harbaum/I2C-Tiny-USB/images/n800.jpg

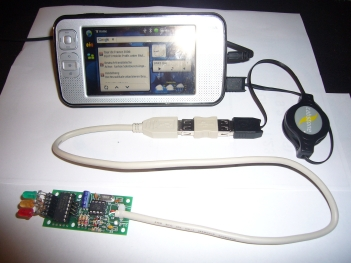
images/n800.jpg
