harbaum/I2C-Tiny-USB/images/screenshot_small.gif

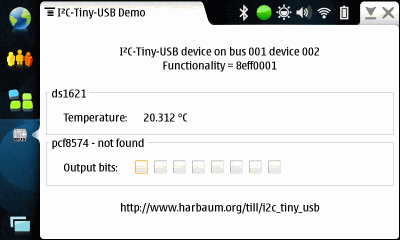
images/screenshot_small.gif
