harbaum/I2C-Tiny-USB/pcb/i2c-tiny-usb/images/i2c-tiny-usb-3d-render.png

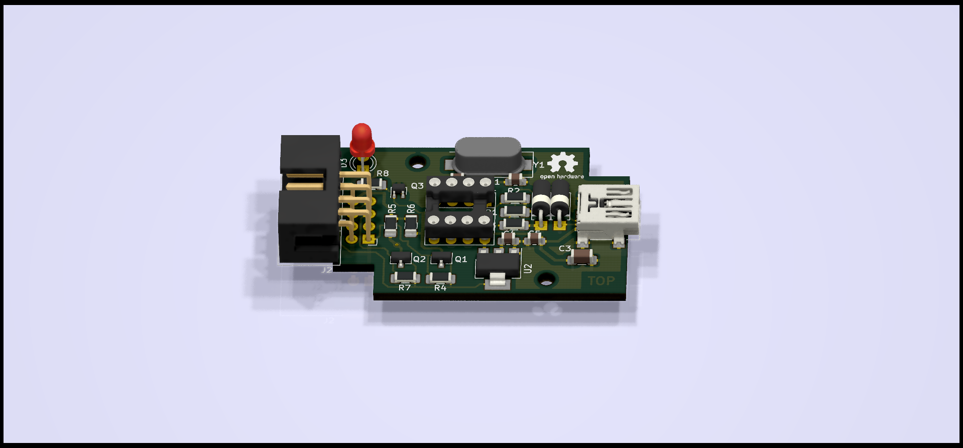
pcb/i2c-tiny-usb/images/i2c-tiny-usb-3d-render.png
