harbaum/I2C-Tiny-USB/pcb/i2c-tiny-usb/images/i2c_tiny_usb_protos.png

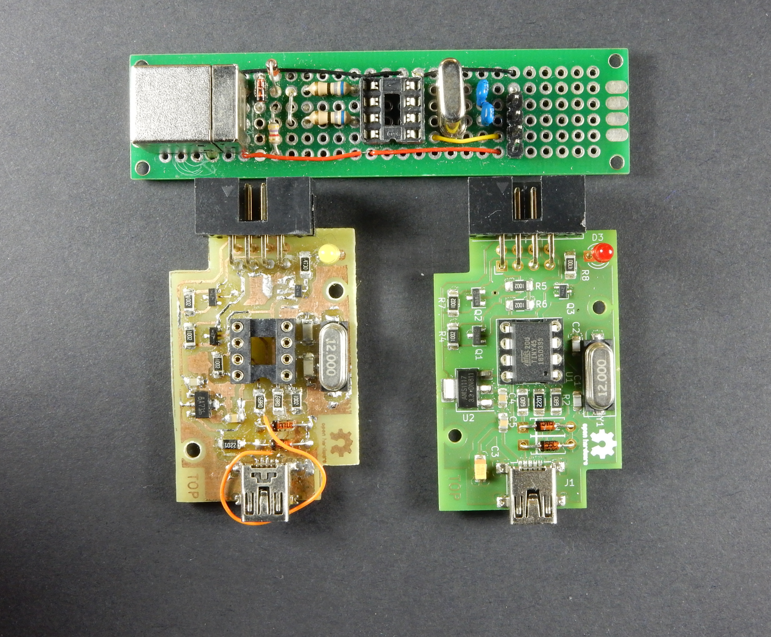
pcb/i2c-tiny-usb/images/i2c_tiny_usb_protos.png
