harbaum/I2C-Tiny-USB/pcb/i2c-tiny-usb/enclosure/i2c-tiny-usb.stl

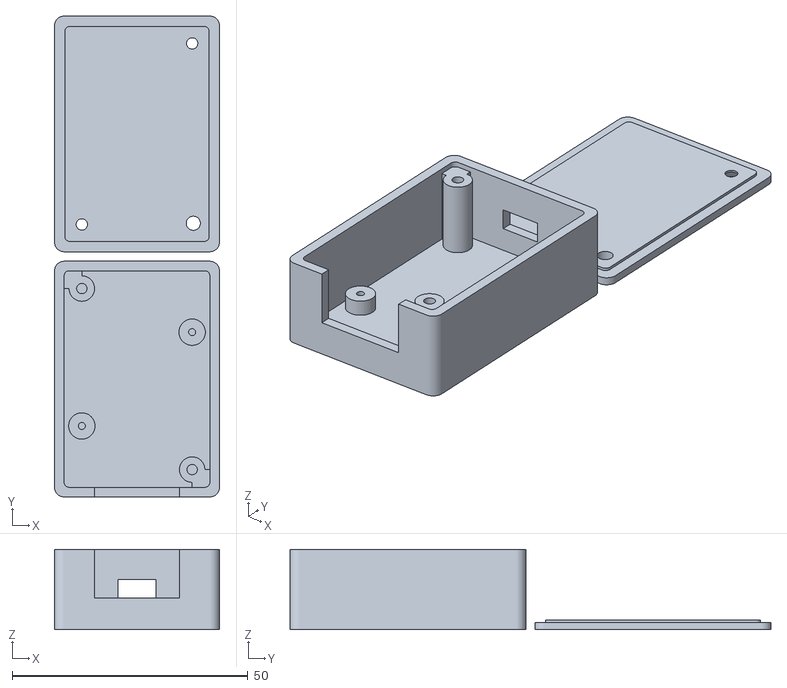
[picture p15: CAD file, 2020-04-05]
pcb/i2c-tiny-usb/enclosure/i2c-tiny-usb.stl
35.0 x 102.0 x 17.0
