harbaum/I2C-Tiny-USB/(threads)

Thread 1 (2017-10-29):

README.md / Henning Pauls i2c-tiny-usb

drawkula, 2017-10-29:
The "Henning Pauls i2c-tiny-usb"  link in "README.md" now points into digital nirwana.

[...but archive.org still has that page.](https://web.archive.org/web/20161015190723/http://home.arcor.de/henning.paul/gallery/avr/)

harbaum, 2017-10-29:
Fixed, thanks.

Closed 2017-10-29.

Thread 4 (2017-11-21):

USB_CFG_LONG_TRANSFERS?

mzwtjp, 2017-11-21:
Hello.
I am trtying i2c-tiny-usb + digispark for my project.
This is a linux host.

I am now trying CFG_USB_LONG_TRANSFERS in usbconfig.h with 1 since I am seeing my I2C read() fails with 205 bytes or larger data.

Though I have not succeeded yet with the larger data transfers, at least I think following changes are needed in order to build this configuration properly.
(At least, passing compilation.)

I wonder if anyone already tried CFG_USB_LONG_TRANSFER configuration.
Or possible clue to solve my issue of not able to read() 205 bytes or more?

====
diff --git a/digispark/main.c b/digispark/main.c
index 472595c..1b7b76e 100644
--- a/digispark/main.c
+++ b/digispark/main.c
@@ -359,7 +359,8 @@ struct i2c_cmd {
 static uchar status = STATUS_IDLE;

-static uchar i2c_do(struct i2c_cmd *cmd) {
+//static uchar i2c_do(struct i2c_cmd *cmd) {
+static usbMsgLen_t i2c_do(struct i2c_cmd *cmd) {
   uchar addr;

   LED_PORT |= LED_BV
@@ -398,7 +399,8 @@ static uchar i2c_do(struct i2c_cmd *cmd) {

   LED_PORT &= ~LED_BV;

-  return(cmd->len?0xff:0x00);
+  //return(cmd->len?0xff:0x00);
+  return(cmd->len?USB_NO_MSG:0x00);
 }

@@ -484,7 +486,8 @@ uchar usbFunctionWrite(uchar *data, uchar len)
 /* ------------------------------------------------------------------------- */
 /* ------------------------ interface to USB driver ------------------------ */
 /* ------------------------------------------------------------------------- */
-uchar  usbFunctionSetup(uchar data[8])
+//uchar        usbFunctionSetup(uchar data[8])
+usbMsgLen_t usbFunctionSetup(uchar data[8])
 {
   static uchar replyBuf[4];
   usbMsgPtr = replyBuf;
====

Thread 5 (2017-11-22):

Read errors with large size data

mzwtjp, 2017-11-22:
Hello.
I am seeing read errors (121 EREMOTEIO) with i2c-tiny-usb + digispark.
Host is Linux, and I am doing something like read(fd, buf, 210) on
/dev/i2c-7 (where my i2c-tiny-usb appears).

I am reading from an I2C device, which can respond relatevely large
size data, say, upto 1,000 bytes.
But I am beginning to see 121 errors around 204 bytes.
(Smaller number of bytes are OK.  read() call fails with larger than this.)

1) If I read one byte at a time like below, I do not get this 121 error.
(But it is very very slow.)

i2c_smbus_read_byte_data(addr, reg)
i2c_smbus_read_byte(addr) x 210 times.

2) I debugged for a while, and I can see if I modify a line in
main.c:usbFunctionRead() like this, I no longer see this error, even
if I do read(fd, buf, 210).

*data = i2c_get_u08(expected == 0)
->
//*data = i2c_get_u08(expected == 0)
*data = 0;

i.e. if I do not call i2c_get_u08() in usbFunctinoRead(), I do not get
this 121 error.

I think if I take long time in usbFunctionRead(), it may cause
something wrong and the read request fails.
(Timeout somewhere related to USB polling loop?)

For 204 bytes, usbFunctionRead() is getting called 26 times
(i2c_get_u08 is called 204 times)

I wonder if there is a way to avoid this within i2c-tiny-usb layer.

harbaum, 2017-11-22:
You are correct. The USB handling is done in software by the usbPoll routine which in turn triggers the i2c transfers. USB is not handled as long as the i2c transfers run and if they take too long either due to the number of bytes transferrred or due to clock stretching then the USB may time out.

Fixing this probably requires a major rewrite of several parts and e.g. the entire I2C handling should be moved into a seperate state machine running besides the usb handling and not instead of it.

mzwtjp, 2017-11-23:
Thank you for your comment.

For now I think I am going to modify my app so that it reads safe amount of chunk bytes at a time, say 100 bytes.
By doing this, I confdirmed that the read speed is OK (compared to the one-byte-at-a-time approach).

Closed 2017-11-23.

Thread 8 (2018-09-05):

Linux GPIOs with I2C-GPIO expanders (PCF8574)

zoobab, 2018-09-05:
Hi,

I have flashed a Digispark with the i2c-tiny-usb firmware, connected a PCF8574, and under linux, it seems you can obtain those 8 GPIOs exported in /sys/class/gpio.

However, I cannot manage to see them there.

Do I need those 10K resistors somewhere? I have the impression the PCF does not receive 5V on its VCC pin, so I suspect this might be the reason. Do you have a better picture or a schema where to place those 10K resistors?

That would be great to document the usage of those, as GPIOs over USB are pretty hard to get (out-of-tree driver, etc...):

http://www.zoobab.com/ch341-usb-spi-i2c-uart-isp-dongle#toc15

zoobab, 2018-09-06:
Should the Digispark adapter appear in the chain when I do an i2cdetect?

drawkula, 2018-09-06:
I just flashed a Digispark...
```
$ lsusb | fgrep i2c
Bus 002 Device 010: ID 0403:c631 Future Technology Devices International, Ltd i2c-tiny-usb interface
$ i2cdetect -l
```
No output. Probably the `i2c-dev` module is missing...
```
$ sudo modprobe i2c-dev
$ i2cdetect -l | fgrep tiny
i2c-10  unknown         i2c-tiny-usb at bus 002 device 010      N/A
```
That's how it looks on my Debian9 notebook. I cannot test more because finding some i2c chips in my electronic sediments would take longer than I got time atm...

zoobab, 2018-09-06:
Will try loading that module this evening...

harbaum, 2018-09-06:
Indeed, you need to approach this step-by-step.

First as outlined by @zoobab make sure the digispark is detected by the linux box. E.g. the lsusb will tell you that.

Second make sure the i2c subsystem of the linux kernel has access to it. This may indeed require modprobing i2c-dev

Now your i2c-tiny-usb is working and everything that happens from here on is not i2c-tiny-usb specific but e.g. is the same with other i2c ports like e.g. the one on the raspberry pi.

Third make sure the pcf8574 is working on i2c. If the `i2cdetect -l | fgrep tiny` e.g gave i2c-10 as the bus id then do a

`i2cdetect -y 10`

This will give you a list of all connected i2c devices and your pcf8574 should show up.

Finally you need to load (modprobe) the pcf8574 driver.

Instructions like http://www.gtkdb.de/index_36_2914.html will help you once the i2c-tiny-usb is properly detected and the i2c bus can be scanned for devices.

harbaum, 2018-09-06:
This one may also be helpful https://ubuntuforums.org/showthread.php?t=1181192&p=8343003#post8343003

zoobab, 2018-09-06:
When I do an ```i2cdetect -y 8```, the dongle disseppears from the USB bus:

```
# i2cdetect -l
i2c-3	i2c       	i915 gmbus dpc                  	I2C adapter
i2c-1	i2c       	i915 gmbus vga                  	I2C adapter
i2c-8	i2c       	i2c-tiny-usb at bus 001 device 038	I2C adapter
i2c-6	i2c       	DPDDC-B                         	I2C adapter
i2c-4	i2c       	i915 gmbus dpb                  	I2C adapter
i2c-2	i2c       	i915 gmbus panel                	I2C adapter
i2c-0	i2c       	i915 gmbus ssc                  	I2C adapter
i2c-7	smbus     	SMBus I801 adapter at efa0      	SMBus adapter
i2c-5	i2c       	i915 gmbus dpd                  	I2C adapter
sabayon /dev # i2cdetect -y 8
     0  1  2  3  4  5  6  7  8  9  a  b  c  d  e  f
00:          -- -- -- -- -- -- -- -- -- -- -- -- --
10: -- -- -- -- -- -- -- -- -- -- -- -- -- -- -- --
20: -- -- -- -- -- -- -- -- -- -- -- -- -- -- -- --
30: -- -- -- -- -- -- -- -- -- -- -- -- -- -- -- --
40: -- -- -- -- -- -- -- -- -- -- -- -- -- -- -- --
50: -- -- -- -- -- -- -- -- -- -- -- -- -- -- -- --
60: -- -- -- -- -- -- -- -- -- -- -- -- -- -- -- --
70: -- -- -- -- -- -- -- --                 
sabayon /dev # lsusb
Bus 001 Device 004: ID 2232:1024 Silicon Motion
Bus 001 Device 003: ID 8087:07da Intel Corp.
Bus 001 Device 002: ID 8087:0024 Intel Corp. Integrated Rate Matching Hub
Bus 001 Device 001: ID 1d6b:0002 Linux Foundation 2.0 root hub
Bus 003 Device 001: ID 1d6b:0003 Linux Foundation 3.0 root hub
Bus 002 Device 001: ID 1d6b:0002 Linux Foundation 2.0 root hub
```

Maybe the firmware is crashing?

harbaum, 2018-09-06:
You are missing the pullups as stated in the readme.

harbaum, 2018-09-10:
Any progress?

zoobab, 2018-09-10:
Will retry this evening with the 2 10K resistors.

zoobab, 2018-09-11:
Will have to wait one more day, today is birthday party, so that will be for tomorrow...

zoobab, 2018-09-17:
I found this nice howto for the MCP23017:

http://elektranox.org/2017/05/0018-collabora/

PizzaProgram, 2020-03-08:
Is that patch applied from Sebastian Reichel?
Is the current driver stable?

harbaum, 2020-03-08:
The current driver is in the main kernel. You just need to check their if the patches you are interested in have been submitted and accepted there. Imho they are included.

PizzaProgram, 2020-03-08:
I could not check, that's why I've asked...

> Imho they are included.
 Than it's OK :-)

Closed 2018-09-15.

Thread 10 (2019-02-08):

/dev/i2c-* disappears after one access

roman1528, 2019-02-08:
Hi.
i got it working after about 2 hours of googleing around the world.
module i2c-dev have to be loaded!!!

now i can execute i2cdetect -y 8
it read all adresses.. find my BME280 at 0x76 and after that, the bus is disappeared in /dev.

why?

can you help me?

EDIT: the usb device isn't listed any more at lsusb after read.

roman1528, 2019-02-08:
I'm sorry!
didn't read enough...
problem got fixed by two 10k pullups^^
thanks

Closed 2020-04-15.

Thread 11 (2019-08-23):

Writing a device tree overlay for a i2c device attached to i2c-tiny-usb

hardillb, 2019-08-23:
Has anybody managed to write a device tree overlay to use a i2c device kernel driver?

I'm trying to connect a touch screen via a i2c-tiny-usb adapter on a raspberry pi (the normal i2c bus is disabled because I'm using a DPI screen).

I've managed to get the interrupt details setup but it looks like the overlay is getting attached to the disabled built in i2c bus and I need to work out how to write an overlay to add the extra i2c bus.

```
/dts-v1/;
/plugin/;

/ {
	compatible = "brcm,bcm2837", "brcm,bcm2835", "brcm,bcm2708", "brcm,bcm2709";

	fragment@0 {
		target = <&i2c>;

		__overlay__ {
			status = "okay";
		};
	};

	fragment@1 {
               target = <&gpio>;
                __overlay__ {
                        st16xx_pins: st16xx_pins {
                                brcm,pins = <27>; /* GPIO */
                                brcm,function = <0>; /* in */
                                brcm,pull = <2>; /* up */
                        };
                };
	};

	fragment@2 {
		target = <&i2c>;
		__overlay__ {
			#address-cells = <1>;
			#size-cells = <0>;
			st16xx: st16xx@38 {
				compatible = "sitronix,st16xx-ts", "sitronix,st16xx";
				reg = <0x38>;
				pinctrl-names = "default";
				interupt-parent = <&gpio>;
				interrupts = <27 0x8>;
			};
		};
	};

	__overrides__ {
                addr = <&st16xx>, "reg:0";
        };

};
```

If I've understood the problem is with the `target = <&i2c>` lines which point to the existing bus. I think I need to create a overlay named `i2c3` to match the new bus.

(also asked on rPi Stack Overflow site here: https://raspberrypi.stackexchange.com/q/101823/37180)

CorvetteCole, 2023-01-17:
how did you figure out the interrupt stuff? trying to get that set up for an APDS9960 sensor

Thread 12 (2019-09-30):

"Failed to read functionality" after program

roycepope, 2019-09-30:
After programming my ATTiny85 with the included main.hex I am getting the following messages in dmesg.

```[ 1795.477019] usb 1-2: USB disconnect, device number 4
[ 1829.201263] usb 3-1.3: new low-speed USB device number 10 using xhci_hcd
[ 1829.291719] usb 3-1.3: New USB device found, idVendor=16d0, idProduct=0753
[ 1829.291726] usb 3-1.3: New USB device strings: Mfr=0, Product=0, SerialNumber=0
[ 1831.328892] usb 3-1.3: USB disconnect, device number 10
[ 1831.558550] usb 3-1.3: new low-speed USB device number 11 using xhci_hcd
[ 1831.639708] usb 3-1.3: New USB device found, idVendor=0403, idProduct=c631
[ 1831.639716] usb 3-1.3: New USB device strings: Mfr=1, Product=2, SerialNumber=3
[ 1831.639720] usb 3-1.3: Product: i2c-tiny-usb
[ 1831.639724] usb 3-1.3: Manufacturer: Till Harbaum
[ 1831.639728] usb 3-1.3: SerialNumber: 0215
[ 1831.640173] i2c-tiny-usb 3-1.3:1.0: version 2.01 found at bus 003 address 011
[ 1831.641538]  (null): failure reading functionality
[ 1831.641575] i2c i2c-4: failure reading functionality
[ 1831.641678] i2c i2c-4: connected i2c-tiny-usb device
```

The device shows up as a "dummy bus"
```[root@OGT-DEBUG commandline]# i2cdetect -l
i2c-4	dummy     	i2c-tiny-usb at bus 003 device 011	Dummy bus
```

I tried it both with 10K resisters and internal resisters. Same error.
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

roycepope, 2019-10-17:
Issue was due to an older kernel https://lore.kernel.org/patchwork/patch/785282/

Running: 4.4.196-1.el7.elrepo.x86_64 and no longer see an issue.

Closed 2019-10-17.

Thread 13 (2019-12-26):

Tiny-USB hangs on host reboot

BeetleX99, 2019-12-26:
Hi,
i2c-tiny-usb (main.hex on digispark) is fine with debian host.

But if the host is rebooting, the tiny doesn´t respond to the usb registering process. After a system reboot just pulling and replugging the hardware module re-enables the module again.

 Any advice for fixing? I am not familiar with the USB state machines...

PizzaProgram, 2020-03-20:
I have just realized:
 This is TRUE!

**After reboot > device is not recognized.** Only manual unplugging / re-plugging helps.

So basically this makes the whole thing useless, unless there's a trick we don't know about?

BeetleX99, 2020-03-20:
I tried something on Linux level, but didn´t succeed. I am not the expert so far.
As the original project was transferred to Digi/Ada, maybe the hangup is caused by this?
Anyone out there, being able to check this? Till?

BeetleX99, 2020-03-20:
Sorry, closed by mistake!

PizzaProgram, 2020-03-26:
Since the author isn't answering, I'm forced to ask:
- Are there **any other** Firmwares doing the same as this one (without bugs like this) ?

zgyarmati, 2020-04-15:
I've looked into this briefly. It seems that this only happen with the digispark port of the i2c-tiny-usb fimware. Digispark uses an USB bootloader [micronucleus](https://github.com/micronucleus/micronucleus), and I suppose (but I didn't really debug this), that the USB bootloader causes the issue.  I think if you flash the original (not Digispark/micronucleus based) fw on the Digispark module's attiny85, than the issue will disappear, without getting/building new hardware.

harbaum, 2020-04-15:
What exactly do you think is the problem? Are other digispark based projects also affected by this?

zgyarmati, 2020-04-16:
Oddly it turned out that with my Digispark (likely a clone, i don't even remember where i bought it) i can't reproduce the issue, neither with reboot nor with switching off and back on my computer, by using the main.hex available in the digispark dir. One variable could be the micronucleus bootloader version. @BeetleX99 , @PizzaProgram, could you please check what bootloader version do you have? It's written when the .hex is flashed with micronucleus as:

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

BeetleX99, 2020-04-16:
Sehr geehrte Damen und Herren,

ich bin bis einschließlich 17.04.2020 nicht im Büro.
Bitte kontaktieren Sie in dringenden Fällen meine Vertretung Tim Kersken unter tk@inotec-feg.de.

Mit freundlichen Grüßen
Holger Runkewitz

Holger Runkewitz | Geschäftsführer | inotec Forschungs- und Entwicklungsgesellschaft mbH | Biedermannstraße 9-13, 04277 Leipzig
hr@inotec-feg.de | fon +49.341.35699024 | fax +49.341.35699029

Dear Sirs and Madames,

I am currently out of office until 4/17/2020.
Please refer all urgent matters to Tim Kersken at tk@inotec-feg.de.

Yours sincerely
Holger Runkewitz

Holger Runkewitz | CEO | inotec Forschungs- und Entwicklungsgesellschaft mbH | Biedermannstraße 9-13, 04277 Leipzig
hr@inotec-feg.de | fon +49.341.35699024 | fax +49.341.35699029

PizzaProgram, 2020-04-16:
I have used a [special fork of micronucleus](https://github.com/mariusgreuel/micronucleus/blob/fecb0c4bbe471c10c05de4212aaa533c83271ee5/commandline/builds/Windows/micronucleus.exe), that is compatible with WinUSB driver, because it was impossible to flash the device with the "normal one".
_(Unknown device keeps popping up only for 2 sec in device manager, so no chance to install a driver.
Zadig.exe is refreshing every 3 sec too.)_

```` E:\3USB>micronucleus --run --dump-progress --type intel-hex main.hex
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
..........
> Writing flash memory...
.....................................................................
> Starting the user application...
> Micronucleus done. Thank you!````

PizzaProgram, 2020-04-16:
````
libwdi:debug [wdi_create_list] Hardware ID: USB\VID_0403&PID_C631&REV_0201
libwdi:debug [wdi_create_list] Compatible ID: USB\Class_00&SubClass_00&Prot_00
libwdi:debug [wdi_create_list] Driverless USB device (2): USB\VID_0403&PID_C631\0070
libwdi:debug [wdi_create_list] Device description: 'i2c-tiny-usb'
````

zgyarmati, 2020-04-16:
I flashed the 1.6 version of the Micronucleus bootloader FW from here: https://github.com/mariusgreuel/micronucleus/tree/v1.06/firmware/releases (the file "micronucleus-1.06.hex") and on the top of that I flashed the i2c-tiny-usb main.hex from this repo. I can't reproduce the issue with rebooting on my Linux box... I see that your OS is Windows, but unfortunately i don't have the means to debug this under Windows.

PizzaProgram, 2020-04-17:
hmmm.... now I don't understand:

1. Is there 2 different .hex file I need to flash? (1 for the boot loader + 1 for the I2C>USB?)
2. How is 1.6 version = 1.06 ?

PizzaProgram, 2020-04-17:
> I can't reproduce the issue with rebooting on my Linux box...

What kind of "box" is that? A Raspberry Pi?
Is that box unpowering for a moment the USB port while rebooting?
 (Because the RPi 4 does NOT >> and that's causing the problem)

BeetleX99, 2020-05-02:
Great News!
I did some testing at CubieTruck and Raspi in parallel, and now I just found the culprit!
If the Tiny runs behind an usb-hub, it will fail in rebooting,
connected directly to the CubieTruck the Tiny is activated after each reboot!!!

zgyarmati, 2020-05-02:
@BeetleX99, thx for sharing this observation! The hub has an external power supply, or host-powered?

PizzaProgram, 2020-05-03:
@BeetleX99 I guess you have an external power at your USB hub. Or maybe a bigger capacitor (condenser) built-in that "holds" the power for a moment while your mainboard is rebooting.
Which gives a great idea:

 The **developers** could use an **external powered USB HUB to simulate and debug** the problem too!

PizzaProgram, 2020-05-03:
I've just quickly looked at the [kerner code ](https://github.com/harbaum/I2C-Tiny-USB/blob/master/kernel/i2c-tiny-usb.c) but I don't find any "`keepalive timer`", that could trigger a re-inic sequence of the device if that signal is **lost**. So this is maybe an architectural problem of the whole code design?

IMHO it's much more difficult to detect a **signal loss**, if not BOTH parties of the communication are keeping track of each other from time to time. _(Maybe once every 1 sec? )_

BeetleX99, 2020-05-04:
My hub doesn´t have an externel power supply.

Gemba, 2021-03-06:
FWIW, you may try this [patch](https://gist.github.com/Gemba/621438f38fd0106393af2b3ab58c82b2).

PizzaProgram, 2021-03-06:
Sounds great! :+1:

Sadly this is a bit too complicated for me how enable this patch on my RPi4.
I guess a new linux Buster kernel release / upgrade will come out soon, and the driver will be auto-upgraded?

... about these lines starting from 14:
```
+    i = 0;
+    while (--i) { /* fake USB disconnect for > 250 ms */
+        _delay_ms(30);
     }
```
How can this run for 250ms if `i=0` ?

Gemba, 2021-04-23:
Maybe it can/will be fixed in a future kernel/firmware (if it can be attributed to be a kernel/firmware issue). I did not update to the latest development [there](https://github.com/raspberrypi/linux).

The `--` is the trick here together with the type of `i`. `--` is an decrement operator which decreases the value of `i` before it gets evaluated in the while condition. As `i` is a uchar/byte it will be `255` at the first evalutaion of `while()`.

PizzaProgram, 2021-04-23:
Maybe I have too low programming knowledge after 35+ years of learning, but this `while` cycle does not seem to be right.
If you say this should run for 250ms, than "--i overflow" start at 255 x 30ms delay = 7650ms.

How about a simple, clear code, that everyone can understand and nobody thinks it's a bug?
```
i = 0;
while (i < 12) { /* fake USB disconnect for > 250 ms */
  ++i;  _delay_ms(25);
}
```
That will run for 250ms, not 7650, or cause any byte-overflow ... `(i <> 12) or (i != 12)` is fine too, I just don't know the exact syntax.

PizzaProgram, 2021-04-23:
>  I did not update to the latest development there...
Why not ?

o2bshane, 2021-05-06:
I too have experience a digispark freezing after a reboot of the host computer. This happens with every micronucleus firmware except the default. It seems we need the digispark to enter bootloader mode to re-initalize the USB connection after the host reboots otherwise it freezes. I've tried using a WDT to reset the digispark and the USB connection but again with a modified micronucleus ( like one that only enters the bootloader on external reset) it freezes without the bootloader resting the USB connection.

Thread 14 (2020-03-08):

Multiple digispark USB

PizzaProgram, 2020-03-08:
How do I change the I2C bus address of a ATTiny85 Digispark dongle, if I would like to use multiple of them on the same Raspberry Pi4? (Or with a USB HUB.)

I guess I have to re-compile the firmware it again for each one?
Checked both digital.h & main.c  files, but did not find any "I2C_BASE_BUS_ADDRESS" or anything similar.

Raspberry Pi4 has 4 I2C buses by default, so this should start from 8+

... or ...
 if the BUS address is given by Debian OS, how /where should I change the name or unique identifier of the flashed device so I can distinguish one from the others?

Sorry if my question is wrong, I'm a newbee to this. Trying to drive more than 64 IO pins:
https://community.openhab.org/t/compatible-usb-i2c-adapter-for-rpi4/93690/6

harbaum, 2020-03-08:
It's not the hardware nor the driver that does the bus enumeration but imho the i2c subsystem of the Linux kernel. And yes, you can simply plug multiple devices into your PC and they'll get individual busses assigned.

PizzaProgram, 2020-03-08:
OK, that's good news :+1:
But How do I rename those similar named USBs, so I can distinguish one from the other?

If each one is named the same, I won't know if that I2C bus is the one with inputs or the outputs... :-(
... and if I configure the IO panels wrong ...

PizzaProgram, 2020-03-12:
This problem is more sever than I've thought.

I've just tested to plug in 2 keys, than unplugged and switched:
 _(I've attacked multiple boards to the first, none to the other)_
```
[23:11:05] openhabian@openhab:~$ sudo i2cdetect -y 7
     0  1  2  3  4  5  6  7  8  9  a  b  c  d  e  f
00:          -- -- -- -- -- -- -- -- -- -- -- -- --
10: -- -- -- -- -- -- -- -- -- -- -- -- -- -- -- --
20: -- 21 22 23 -- -- -- -- -- -- -- -- -- -- -- --
30: -- -- -- -- -- -- -- -- -- -- -- -- -- -- -- --
40: -- -- -- -- -- -- -- -- -- -- -- -- -- -- -- --
50: -- 51 -- -- -- -- -- -- -- -- -- -- -- -- -- --
60: -- -- -- -- -- -- -- -- -- -- -- -- -- -- -- --
70: -- -- -- -- -- -- -- --
```
Depending which device I've plugged first and what USB order, the BUS# got reordered.
It can cause big problems, if board were previously configured for inputs but suddenly start get output signals. _(Planning to plug in similar board to each one.)_
```
[23:15:30] openhabian@openhab:~$ sudo i2cdetect -l
i2c-1   i2c             bcm2835 I2C adapter                     I2C adapter
i2c-8   i2c             i2c-tiny-usb at bus 001 device 006      I2C adapter
i2c-7   i2c             i2c-tiny-usb at bus 001 device 004      I2C adapter
[23:15:59] openhabian@openhab:~$ sudo i2cdetect -l
[sudo] password for openhabian:
i2c-1   i2c             bcm2835 I2C adapter                     I2C adapter
i2c-8   i2c             i2c-tiny-usb at bus 001 device 010      I2C adapter
i2c-7   i2c             i2c-tiny-usb at bus 001 device 008      I2C adapter
[19:45:40] openhabian@openhab:~$ sudo i2cdetect -y 7
     0  1  2  3  4  5  6  7  8  9  a  b  c  d  e  f
00:          -- -- -- -- -- -- -- -- -- -- -- -- --
10: -- -- -- -- -- -- -- -- -- -- -- -- -- -- -- --
20: -- -- -- -- -- -- -- -- -- -- -- -- -- -- -- --
30: -- -- -- -- -- -- -- -- -- -- -- -- -- -- -- --
40: -- -- -- -- -- -- -- -- -- -- -- -- -- -- -- --
50: -- -- -- -- -- -- -- -- -- -- -- -- -- -- -- --
60: -- -- -- -- -- -- -- -- -- -- -- -- -- -- -- --
70: -- -- -- -- -- -- -- --
```

PizzaProgram, 2020-03-12:
Found [this](https://manpages.debian.org/jessie/linux-manual-3.16/i2c_add_numbered_adapter.9.en.html), but don't know how to implement it.
Also opened  a Topic [at RPi forum](https://www.raspberrypi.org/forums/viewtopic.php?f=91&t=267714), but no answers yet.

harbaum, 2020-03-12:
Other possible solution: add an i2c eeprom to each bus with some unique I'd. Then read the eeprom to know which bus you are talking to.

PizzaProgram, 2020-03-12:
I still believe it is easier to modify the name of each firmware.
Found these 2 lines at [usbconfig.h](https://github.com/harbaum/I2C-Tiny-USB/blob/master/digispark/usbconfig.h) :
#define	USB_CFG_DEVICE_NAME		'i','2','c','-','t','i','n','y','-','u','s','b'
#define	USB_CFG_DEVICE_NAME_LEN	12

So, if I find out how to recompile 10x with alternate numbered names, like:
#define	USB_CFG_DEVICE_NAME		'i','2','c','-','t','i','n','y','-','u','s','b','-','5','1'
#define	USB_CFG_DEVICE_NAME_LEN	15
... than I can maybe put an overlay to boot loader of RPi. (config.txt) to define a fixed I2C BUS address attached 1-1 to each name.

_My fear is:_
  - What if the diver won't recognise it, because of the name-change?

harbaum, 2020-03-12:
The driver recognizes the device by USB IDs. Changing the name should not hurt.

drawkula, 2020-03-12:
Maybe setting
```
/*#define USB_CFG_SERIAL_NUMBER   'N', 'o', 'n', 'e' */                                       
/*#define USB_CFG_SERIAL_NUMBER_LEN   0 */                                                    
```
and trying to detect this in an own UDEV rule is safer.

I don't know what UDEV can do with I2C devices, but for others it e.g. can make symlinks with names you want.

See: http://hintshop.ludvig.co.nz/show/persistent-names-usb-serial-devices

zgyarmati, 2020-04-15:
Indeed, using udev is the canonical way to solve this kind of issues under Linux.
If you run `udevadm monitor` (as root), while plugging in/unplugging the device, you will see the corresponding udev events, for instance on  my laptop:

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

As you can see, also the USB port is identified, so if you plug the devices always to the same port, you can also identify them, and creating a symlink to the freshly created I2C device accordingly.

If the USB port is not predictable, than you can also run an external program from the udev rule to create the desired name for the device (ie. i2cdetect via a bash script to get the available i2c slave addresses on the plugged in i2c bus), and based on the available addresses, you can figure out which bus you are on. See http://www.reactivated.net/writing_udev_rules.html#external-naming.

harbaum, 2020-04-15:
You can also distinguish the devices by their position in the physical USB device tree. This information can be gathered from the sysfs or indirectly using tools line usb-devices.

PizzaProgram, 2020-04-16:
> while plugging in/unplugging the device
That's not possible if working remotely. The device HAS TO HAVE a unique name so it can be identified. Like: `i2c-tiny-usb-pushbuttons-inputs` or `i2c-tiny-usb-rollersh-outputs`

> You can also distinguish the devices by their position in the physical USB device tree
That's an other possibility that CAN happen in real life scenarios and needs to be prevented:
 - what if someone is switching the order? Or the USB HUB needs to be replaced? etc...

A unique identification is needed to set FIXed I2C Bus addresses, so no accidents may happen even if:
 - one of the devices gets unplugged and plugged in into an other USB slot or to a HUB
 - if the system reboots and order changes

A wrong identification of the bus number or device name can cause serious problems.
_(After a power-outage the solar system overheats, or the roller shutter goes suddenly down to the kids head.. etc.)_

zgyarmati, 2020-04-16:
> > while plugging in/unplugging the device
>
> That's not possible if working remotely. The device HAS TO HAVE a unique name so it can be identified. Like: `i2c-tiny-usb-pushbuttons-inputs` or `i2c-tiny-usb-rollersh-outputs`
Ah, i meant that you can use the `udevadm monitor` during development, to figure out what events/filters to implement in your udev rule.

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

Well, in this scenario either you have to physically make impossible to connect the devices to other USB plugs or/and indeed identify the bus somehow, for example by the available I2C addresses on the bus (if they are different), or as @harbaum  suggested, by placing an i2c eeprom to each bus with some unique ID.
Of course it's also possible to flash different fw-s (with different name or PID) to your i2c-tiny-usb boards as suggested above, but in my experience it's can get messy if one site have multiple devices with almost the same fw (what if you have to replace because of malfunction or anything).
If you can share same details about your I2C busses (and about the differences between them on which it's possible to distinguish them, if any), i think we can lay out a more specific example.

Thread 17 (2020-12-30):

Atmega8 firmware variant doesn't work

sleeply4cat, 2020-12-30:
Checked USBTiny and AVRUSB variants with custom pcb and noname prototype board, both failed. Besides, other projects (like https://github.com/gblargg/vusb-joystick) works nice with my HW.
I connected D+ and D- to D2 and D3 accordingly:
```
#define	USB_CFG_IOPORTNAME		D
#define	USB_CFG_DMINUS_BIT		3
#define	USB_CFG_DPLUS_BIT		2
```

but after programming everything I can see in dmesg is
> [413259.524068] usb 1-1.3: new low-speed USB device number 32 using ehci-pci
> [413259.608062] usb 1-1.3: device descriptor read/64, error -32

Thread 18 (2021-05-07):

Will I2C-Tiny-USB work with LilyPads based on the ATTiny85

speendo, 2021-05-07:
I want to try to replicate this project. However, I have a hard time obtaining a ATTiny85 chip with a MicroUSB-Port (like the blue one here: https://www.aliexpress.com/item/32432747996.html). I tried to order it twice but the order got cancelled each time as it doesn't seem to be available atm.

However, there are plenty of offers for a LilyPad with the ATTiny85 (e.g. here: https://www.aliexpress.com/item/4000943968380.html).

Is there any reason the project would not work with this board?

Side note: I also found offers for the digispark, however I would prefer a solution with a MicroUSB cable.

speendo, 2021-06-15:
I tried it out myself, the library also works with the LilyPad based on the ATTiny85.

For future readers: if you have problems flashing the firmware on you ATTiny85, make sure it has a bootloader installed. I had a very hard time to realize there was no bootloader on my LilyPad and then to flash the bootloader on the chip. But it did work.

@harbaum: in case you want to add the board to [this page](https://github.com/harbaum/I2C-Tiny-USB/tree/master/digispark) I can provide some pictures.

Thread 19 (2021-05-10):

Driver hangs on i2cdetect if nothing connected (digispark)

prandeamus, 2021-05-10:
I downloaded the firmware for the Digispark variant and it works fine, at least on initial testing - for example I can plug the Digispark into my Linux laptop, connect to an MCP23017 and ensure it has pullup 10K resistors, and it can detect the device (i2cdetect -y 6 in my case works fine)

However if I just plug in the digispark and let it initialise, then run i2cdetect -y <busnumber> the driver stops working altogether. Now, to be fair, I'm not expecting a meaningful result here. If you are running open collector, connecting to nothing, not even terminators, it's unreasonable to expect any data. But it seems bad to let the USB driver crash, because the only way to recover seems to be to power cycle the digispark by removing it from the USB and reinserting it.

Is this expected behaviour and is there any way to make the device at least self-heal without requiring manual power cycling? Maybe for example having a watchdog timer to force a reset if the usb polling loop breaks?

harbaum, 2021-07-09:
Have you added pullups to the i2c lines? If not the firmware will wait forever for the lines to go into high/idle state.

prandeamus, 2021-07-09:
Oh yes, if I add pull-ups it does work. I am not complaining that I2C without pullups doesn't work because they are part of the spec.

My point is that if the firmware waits "forever" the linux driver gives up (it probably has a timeout if it gets no response from the USB, which is fair). At that point, the only way out is to powercycle the ATTINY85. OK maybe you can do a RESET but if like me you are using a digispark clone the only option is to take the USB plug out and put it back again.

Would it not at least be possible to have a watchdog on the ATTINY85 and if it has absolutely no response on the bus of any kind for (say) 10 seconds, it could reset itself? That would mean it would drop into any bootloader or restart the app and there might be a chance that the system would self-heal and the linux driver would re-initialise?

Thread 26 (2024-10-08):

Issues with macOS

dakhnod, 2024-10-08:
I am trying to use a digispark with macOS.
Sadly, it doesn't show up under /dev/, like it does on linux.

Furthermore, I cannot find any driver on macOS, and I don't know where to download it.

Is it included in macOS? How would I interface with the chip in macOS?

M1, 14.4.1
