harbaum/I2C-Tiny-USB/pcb/parts.pdf

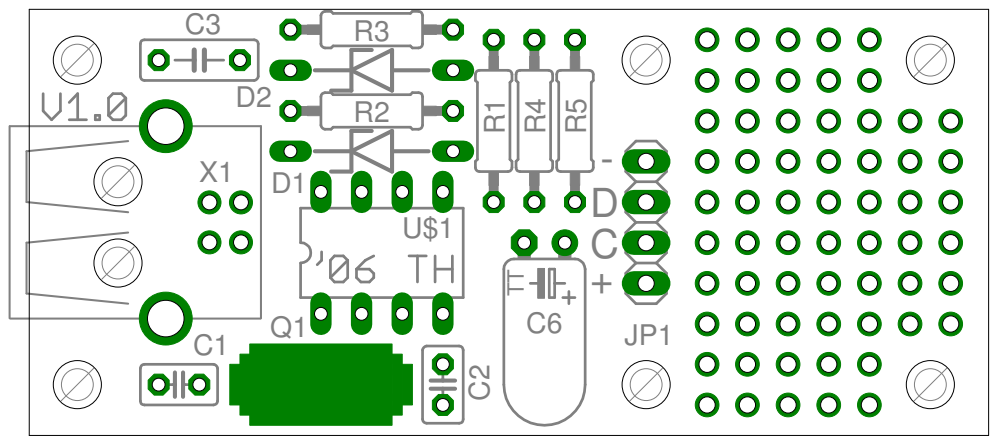
[picture p16: page 1]
