harbaum/I2C-Tiny-USB/pcb/schematic.pdf

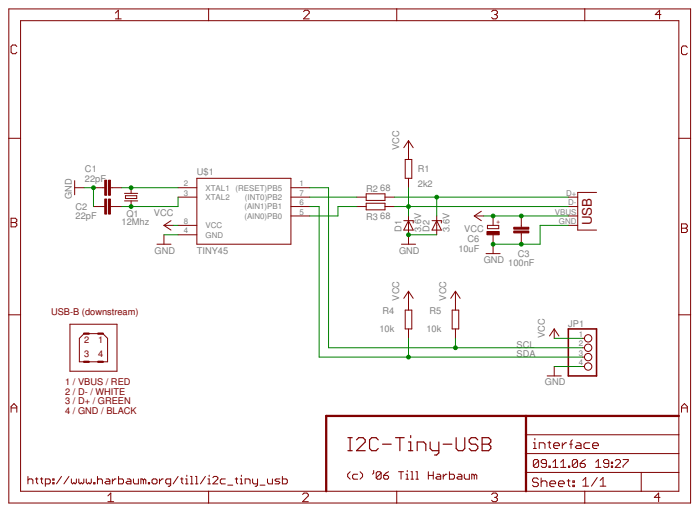
[picture p17: page 1]
