harbaum/I2C-Tiny-USB/pcb/pcb_bottom.pdf

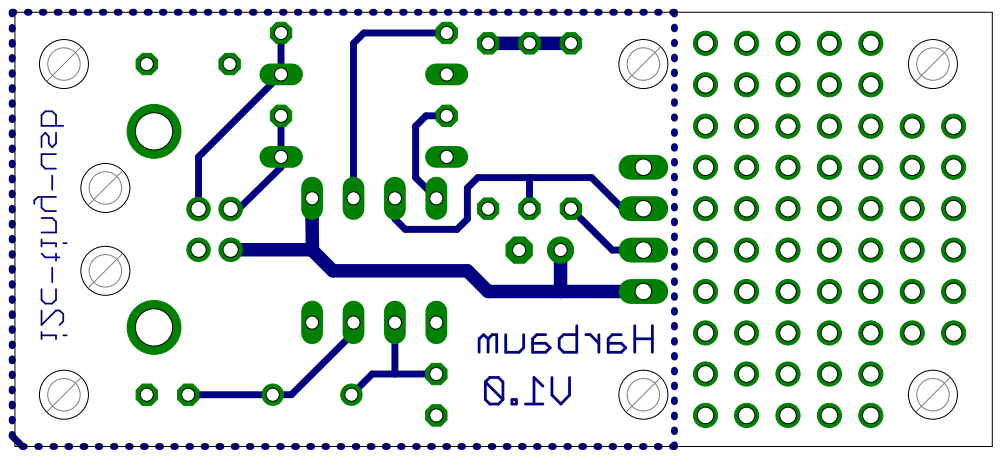
[picture p18: page 1]
