harbaum/I2C-Tiny-USB/pcb/pcb_top.pdf

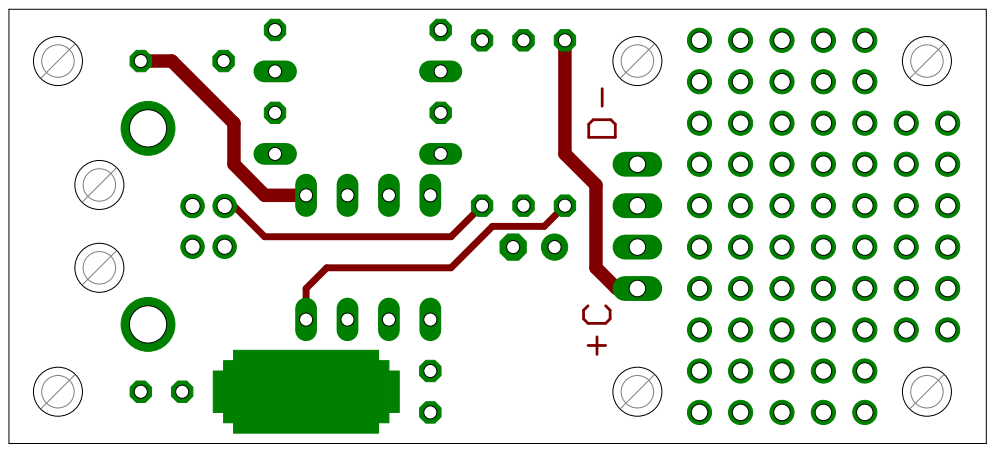
[picture p19: page 1]
