harbaum/I2C-Tiny-USB/pcb/i2c-tiny-usb/i2c-tiny-usb.sch

## KiCad design pcb/i2c-tiny-usb/i2c-tiny-usb.sch (2020-04-05)

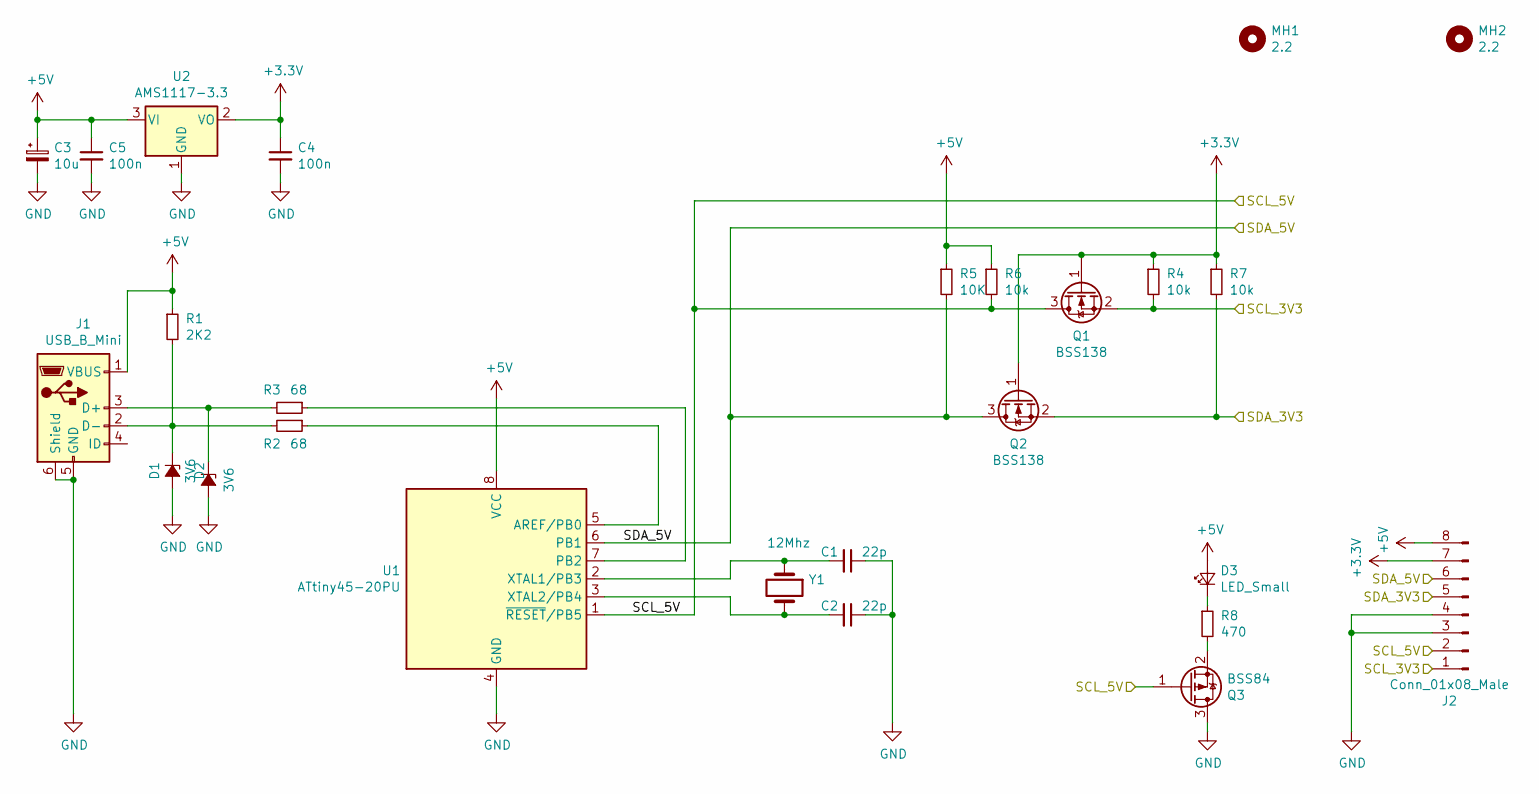
[picture p22: schematic i2c-tiny-usb.sch]

Parts:
C1, C2: 22p; C_0805_2012Metric_Pad1.15x1.40mm_HandSolder
C3: 10u; C_1206_3216Metric_Pad1.42x1.75mm_HandSolder
C4, C5: 100n; C_0805_2012Metric_Pad1.15x1.40mm_HandSolder
D1, D2: 3V6; D_A-405_P7.62mm_Horizontal
D3: LED_Small; LED_D3.0mm
J1: USB_B_Mini; USB_Mini-B_Lumberg_2486_01_Horizontal
J2: Conn_01x08_Male; IDC-Header_2x04_P2.54mm_Horizontal
MH1, MH2: 2.2; MountingHole_2.2mm_M2
Q1, Q2: BSS138; SOT-23
Q3: BSS84; SOT-323_SC-70
R1: 2K2; R_1206_3216Metric_Pad1.42x1.75mm_HandSolder
R2, R3: 68; R_1206_3216Metric_Pad1.42x1.75mm_HandSolder
R4, R6, R7: 10k; R_1206_3216Metric_Pad1.42x1.75mm_HandSolder
R5: 10K; R_1206_3216Metric_Pad1.42x1.75mm_HandSolder
R8: 470; R_1206_3216Metric_Pad1.42x1.75mm_HandSolder
U1: ATtiny45-20PU; DIP-8_W7.62mm_Socket_LongPads
U2: AMS1117-3.3; SOT-223-3_TabPin2
Y1: 12Mhz; Crystal_SMD_HC49-SD

Connections:
+3.3V: C4.1, J2.7, Q1.1 (G), Q2.1 (G), R4.1, R7.1, U2.2 (VO)
+5V: C3.1, C5.1, D3.2 (A), J1.1 (VBUS), J2.8, R1.1, R5.1, R6.1, U1.8 (VCC), U2.3 (VI)
GND: C1.1, C2.1, C3.2, C4.2, C5.2, D1.2 (A), D2.2 (A), J1.5 (GND), J1.6 (Shield), J2.3, J2.4, Q3.3 (D), U1.4 (GND), U2.1 (GND)
unnamed: C1.2, U1.2 (XTAL1/PB3), Y1.1
unnamed: C2.2, U1.3 (XTAL2/PB4), Y1.2
unnamed: D1.1 (K), J1.2 (D-), R1.2, R2.2
unnamed: D2.1 (K), J1.3 (D+), R3.2
unnamed: D3.1 (K), R8.1
unnamed: Q3.2 (S), R8.2
unnamed: R2.1, U1.5 (AREF/PB0)
unnamed: R3.1, U1.7 (PB2)
SCL_3V3: J2.1, Q1.2 (S), R4.2
SCL_5V: J2.2, Q1.3 (D), Q3.1 (G), R6.2, U1.1 (~RESET~/PB5)
SDA_3V3: J2.5, Q2.2 (S), R7.2
SDA_5V: J2.6, Q2.3 (D), R5.2, U1.6 (PB1)
