harbaum/I2C-Tiny-USB/pcb/kicad/interface.sch

## KiCad design pcb/kicad/interface.sch (2017-11-03)

Schematic: interface.sch

Parts:
C1, C2: 22pF; C_Disc_D3.0mm_W1.6mm_P2.50mm
C3: 100nF; C_Disc_D5.0mm_W2.5mm_P5.00mm
C6: 10µF; CP_Radial_D5.0mm_P2.50mm
D1, D2: 3.6V; D_DO-35_SOD27_P10.16mm_Horizontal
J1: USB_B
JP1: Conn_01x04; Pin_Header_Straight_1x04_Pitch2.54mm
Q1: 12MHz; Crystal_HC49-4H_Vertical
R1: 2.2kΩ; R_Axial_DIN0207_L6.3mm_D2.5mm_P10.16mm_Horizontal
R2, R3: 68Ω; R_Axial_DIN0207_L6.3mm_D2.5mm_P10.16mm_Horizontal
R4, R5: 10kΩ; R_Axial_DIN0207_L6.3mm_D2.5mm_P10.16mm_Horizontal
U1: ATTINY45-20PU; DIP-8_W7.62mm
