harbaum/I2C-Tiny-USB/digispark/main.c

/* Name: main.c

 * i2c_tiny_usb on LittleWire
 * Version 2.01
 * Copyright (C) 2015 Jay Carlson. See licensing terms below.
 * Modified by Jay Carlson, 2015-03-31
 *
 * This is a crude cut&paste of Till Harbaum's Linux i2c driver into
 * Ihsan Kehribar's LittleWire firmware, which uses obdev.at's software
 * USB stack.
 *

 -----------------------------------------------------------
 - Little Wire 
 - Firmware Version: 1.3
 - Modified by: ihsan Kehribar, 2013 September
 -----------------------------------------------------------

 -----------------------------------------------------------
 - Little Wire 
 - Firmware Version: 1.2
 - Modified by: ihsan Kehribar, 2013 April
 -----------------------------------------------------------

 -----------------------------------------------------------
 - Little Wire 
 - Firmware Version: 1.1
 - Modified by: ihsan Kehribar, 2012 July
 -----------------------------------------------------------

  modified by ihsan Kehribar, 2011 November
  
  created by chris chung, 2010 April

  based on the works found in

  v-usb framework http://www.obdev.at/vusb/
	 Project: Thermostat based on AVR USB driver
	 Author: Christian Starkjohann
    
  usbtiny isp http://www.xs4all.nl/~dicks/avr/usbtiny/
  	Dick Streefland
  
  please observe licensing term from the above two projects

	Copyright (C) 2010  chris chung

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
 */

#include <avr/io.h>
#include <avr/wdt.h>
#include <avr/eeprom.h>
#include <avr/interrupt.h>
#include <avr/pgmspace.h>
#include <avr/power.h>
#include <util/delay_basic.h>
#include <util/delay.h>
#include <util/atomic.h>
#include <stdlib.h>
#include <string.h>
#include "usbdrv.h"
#include "digital.h"

#define sbi(register,bit) (register|=(1<<bit))
#define cbi(register,bit) (register&=~(1<<bit))

static uint8_t *EE_addr = (uint8_t *)32;
int usbDescriptorStringSerialNumber[] = {
    USB_STRING_DESCRIPTOR_HEADER( USB_CFG_SERIAL_NUMBER_LEN ),
    USB_CFG_SERIAL_NUMBER
};

#define DEBUGF(s, ...)

#define ENABLE_SCL_EXPAND

/* commands from USB, must e.g. match command ids in kernel driver */
#define CMD_ECHO       0
#define CMD_GET_FUNC   1
#define CMD_SET_DELAY  2
#define CMD_GET_STATUS 3

#define CMD_I2C_IO     4
#define CMD_I2C_BEGIN  1  // flag fo I2C_IO
#define CMD_I2C_END    2  // flag fo I2C_IO

/* linux kernel flags */
#define I2C_M_TEN		0x10	/* we have a ten bit chip address */
#define I2C_M_RD		0x01
#define I2C_M_NOSTART		0x4000
#define I2C_M_REV_DIR_ADDR	0x2000
#define I2C_M_IGNORE_NAK	0x1000
#define I2C_M_NO_RD_ACK		0x0800

/* To determine what functionality is present */
#define I2C_FUNC_I2C			0x00000001
#define I2C_FUNC_10BIT_ADDR		0x00000002
#define I2C_FUNC_PROTOCOL_MANGLING	0x00000004 /* I2C_M_{REV_DIR_ADDR,NOSTART,..} */
#define I2C_FUNC_SMBUS_HWPEC_CALC	0x00000008 /* SMBus 2.0 */
#define I2C_FUNC_SMBUS_READ_WORD_DATA_PEC  0x00000800 /* SMBus 2.0 */ 
#define I2C_FUNC_SMBUS_WRITE_WORD_DATA_PEC 0x00001000 /* SMBus 2.0 */ 
#define I2C_FUNC_SMBUS_PROC_CALL_PEC	0x00002000 /* SMBus 2.0 */
#define I2C_FUNC_SMBUS_BLOCK_PROC_CALL_PEC 0x00004000 /* SMBus 2.0 */
#define I2C_FUNC_SMBUS_BLOCK_PROC_CALL	0x00008000 /* SMBus 2.0 */
#define I2C_FUNC_SMBUS_QUICK		0x00010000 
#define I2C_FUNC_SMBUS_READ_BYTE	0x00020000 
#define I2C_FUNC_SMBUS_WRITE_BYTE	0x00040000 
#define I2C_FUNC_SMBUS_READ_BYTE_DATA	0x00080000 
#define I2C_FUNC_SMBUS_WRITE_BYTE_DATA	0x00100000 
#define I2C_FUNC_SMBUS_READ_WORD_DATA	0x00200000 
#define I2C_FUNC_SMBUS_WRITE_WORD_DATA	0x00400000 
#define I2C_FUNC_SMBUS_PROC_CALL	0x00800000 
#define I2C_FUNC_SMBUS_READ_BLOCK_DATA	0x01000000 
#define I2C_FUNC_SMBUS_WRITE_BLOCK_DATA 0x02000000 
#define I2C_FUNC_SMBUS_READ_I2C_BLOCK	0x04000000 /* I2C-like block xfer  */
#define I2C_FUNC_SMBUS_WRITE_I2C_BLOCK	0x08000000 /* w/ 1-byte reg. addr. */
#define I2C_FUNC_SMBUS_READ_I2C_BLOCK_2	 0x10000000 /* I2C-like block xfer  */
#define I2C_FUNC_SMBUS_WRITE_I2C_BLOCK_2 0x20000000 /* w/ 2-byte reg. addr. */
#define I2C_FUNC_SMBUS_READ_BLOCK_DATA_PEC  0x40000000 /* SMBus 2.0 */
#define I2C_FUNC_SMBUS_WRITE_BLOCK_DATA_PEC 0x80000000 /* SMBus 2.0 */

#define I2C_FUNC_SMBUS_BYTE I2C_FUNC_SMBUS_READ_BYTE | \
                            I2C_FUNC_SMBUS_WRITE_BYTE
#define I2C_FUNC_SMBUS_BYTE_DATA I2C_FUNC_SMBUS_READ_BYTE_DATA | \
                                 I2C_FUNC_SMBUS_WRITE_BYTE_DATA
#define I2C_FUNC_SMBUS_WORD_DATA I2C_FUNC_SMBUS_READ_WORD_DATA | \
                                 I2C_FUNC_SMBUS_WRITE_WORD_DATA
#define I2C_FUNC_SMBUS_BLOCK_DATA I2C_FUNC_SMBUS_READ_BLOCK_DATA | \
                                  I2C_FUNC_SMBUS_WRITE_BLOCK_DATA
#define I2C_FUNC_SMBUS_I2C_BLOCK I2C_FUNC_SMBUS_READ_I2C_BLOCK | \
                                  I2C_FUNC_SMBUS_WRITE_I2C_BLOCK

#define I2C_FUNC_SMBUS_EMUL I2C_FUNC_SMBUS_QUICK | \
                            I2C_FUNC_SMBUS_BYTE | \
                            I2C_FUNC_SMBUS_BYTE_DATA | \
                            I2C_FUNC_SMBUS_WORD_DATA | \
                            I2C_FUNC_SMBUS_PROC_CALL | \
                            I2C_FUNC_SMBUS_WRITE_BLOCK_DATA | \
                            I2C_FUNC_SMBUS_WRITE_BLOCK_DATA_PEC | \
                            I2C_FUNC_SMBUS_I2C_BLOCK

/* the currently support capability is quite limited */
const unsigned long func PROGMEM = I2C_FUNC_I2C | I2C_FUNC_SMBUS_EMUL;

#define LED_DDR DDRB
#define LED_PIN PINB
#define LED_PORT PORTB
#define LED_BV _BV(1)

#define I2C_DDR DDRB
#define I2C_PIN PINB
#define I2C_PORT PORTB

// Pins to be used in the bit banging
#define I2C_CLK 2
#define I2C_DAT 0

#define I2C_SDA _BV(0)
#define I2C_SCL _BV(2)

/* Scoped, this delay offset gives 102kHz. Close enough. */
#define DELAY_OVERHEAD 7UL

/* Scale up the delay to match 12MHz -> 16.5MHz clock */
#define DEFAULT_DELAY (((10UL * 1650UL + 60UL) / 1200UL) - DELAY_OVERHEAD)

static uint16_t clock_delay = DEFAULT_DELAY;
static uint16_t clock_delay2 = DEFAULT_DELAY / 2;

static uint16_t expected = 0;
static unsigned char saved_cmd;

#define I2C_IS_AN_OPEN_COLLECTOR_BUS

static void i2c_io_set_sda(uchar hi) {
  if(hi) {
    I2C_DDR  &= ~I2C_SDA;    // high -> input
#ifndef I2C_IS_AN_OPEN_COLLECTOR_BUS
    I2C_PORT |=  I2C_SDA;    // with pullup
#endif
  } else {
    I2C_DDR  |=  I2C_SDA;    // low -> output
#ifndef I2C_IS_AN_OPEN_COLLECTOR_BUS
    I2C_PORT &= ~I2C_SDA;    // drive low
#endif
  }
}

static uchar i2c_io_get_sda(void) {
  return(I2C_PIN & I2C_SDA);
}

static void i2c_io_set_scl(uchar hi) {
#ifdef ENABLE_SCL_EXPAND
  _delay_loop_2(clock_delay2);
  if(hi) {
    I2C_DDR &= ~I2C_SCL;          // port is input
#ifndef I2C_IS_AN_OPEN_COLLECTOR_BUS
    I2C_PORT |= I2C_SCL;          // enable pullup
#endif

    // wait while pin is pulled low by client
    while(!(I2C_PIN & I2C_SCL));
  } else {
    I2C_DDR |= I2C_SCL;           // port is output
#ifndef I2C_IS_AN_OPEN_COLLECTOR_BUS
    I2C_PORT &= ~I2C_SCL;         // drive it low
#endif
  }
  _delay_loop_2(clock_delay);
#else
  _delay_loop_2(clock_delay2);

#ifndef I2C_IS_AN_OPEN_COLLECTOR_BUS
  if(hi) I2C_PORT |=  I2C_SCL;    // port is high
  else   I2C_PORT &= ~I2C_SCL;    // port is low
#endif

  _delay_loop_2(clock_delay);
#endif
}

static void i2c_init(void) {
  /* init the sda/scl pins */
  I2C_DDR &= ~I2C_SDA;            // port is input
#ifndef I2C_IS_AN_OPEN_COLLECTOR_BUS
  I2C_PORT |= I2C_SDA;            // enable pullup
#else
  I2C_PORT &= ~I2C_SDA; // There is a perfectly good pullup on the bus.
#endif /* I2C_IS_AN_OPEN_COLLECTOR_BUS */

#ifdef ENABLE_SCL_EXPAND
  I2C_DDR &= ~I2C_SCL;            // port is input
#ifndef I2C_IS_AN_OPEN_COLLECTOR_BUS
  I2C_PORT |= I2C_SCL;            // enable pullup
#else
  I2C_PORT &= ~I2C_SCL; // There is a perfectly good pullup on the bus.
#endif /* I2C_IS_AN_OPEN_COLLECTOR_BUS */
#else
  I2C_DDR |= I2C_SCL;             // port is output
#endif

  /* no bytes to be expected */
  expected = 0;
}

/* clock HI, delay, then LO */
static void i2c_scl_toggle(void) {
  i2c_io_set_scl(1);
  i2c_io_set_scl(0);
}

/* i2c start condition */
static void i2c_start(void) {
  i2c_io_set_sda(0);
  i2c_io_set_scl(0);
}

/* i2c repeated start condition */
static void i2c_repstart(void) 
{
  /* scl, sda may not be high */
  i2c_io_set_sda(1);
  i2c_io_set_scl(1);
  
  i2c_io_set_sda(0);
  i2c_io_set_scl(0);
}

/* i2c stop condition */
void i2c_stop(void) {
  i2c_io_set_sda(0);
  i2c_io_set_scl(1);
  i2c_io_set_sda(1);
}

uchar i2c_put_u08(uchar b) {
  char i;

  for (i=7;i>=0;i--) {
    if ( b & (1<<i) )  i2c_io_set_sda(1);
    else               i2c_io_set_sda(0);
    
    i2c_scl_toggle();           // clock HI, delay, then LO
  }
  
  i2c_io_set_sda(1);            // leave SDL HI
  i2c_io_set_scl(1);            // clock back up

  b = i2c_io_get_sda();         // get the ACK bit
  i2c_io_set_scl(0);            // not really ??

  return(b == 0);               // return ACK value
}

uchar i2c_get_u08(uchar last) {
  char i;
  uchar c,b = 0;

  i2c_io_set_sda(1);            // make sure pullups are activated
  i2c_io_set_scl(0);            // clock LOW

  for(i=7;i>=0;i--) {
    i2c_io_set_scl(1);          // clock HI
    c = i2c_io_get_sda();
    b <<= 1;
    if(c) b |= 1;
    i2c_io_set_scl(0);          // clock LO
  }

  if(last) i2c_io_set_sda(1);   // set NAK
  else     i2c_io_set_sda(0);   // set ACK

  i2c_scl_toggle();             // clock pulse
  i2c_io_set_sda(1);            // leave with SDL HI

  return b;                     // return received byte
}

void i2c_scan(void) {
  uchar i = 0;

  for(i=0;i<127;i++) {
    i2c_start();                  // do start transition
    if(i2c_put_u08(i << 1))       // send DEVICE address
      DEBUGF("I2C device at address 0x%x\n", i);

    i2c_stop();
  }
}

/* ------------------------------------------------------------------------- */

struct i2c_cmd {
  unsigned char type;
  unsigned char cmd;
  unsigned short flags;
  unsigned short addr;
  unsigned short len;  
};

#define STATUS_IDLE          0
#define STATUS_ADDRESS_ACK   1
#define STATUS_ADDRESS_NAK   2

static uchar status = STATUS_IDLE;


static uchar i2c_do(struct i2c_cmd *cmd) {
  uchar addr;

  LED_PORT |= LED_BV

  DEBUGF("i2c %s at 0x%02x, len = %d\n", 
	   (cmd->flags&I2C_M_RD)?"rd":"wr", cmd->addr, cmd->len); 

  /* normal 7bit address */
  addr = ( cmd->addr << 1 );
  if (cmd->flags & I2C_M_RD )
    addr |= 1;

  if(cmd->cmd & CMD_I2C_BEGIN) 
    i2c_start();
  else 
    i2c_repstart();    

  // send DEVICE address
  if(!i2c_put_u08(addr)) {
    DEBUGF("I2C read: address error @ %x\n", addr);

    status = STATUS_ADDRESS_NAK;
    expected = 0;
    i2c_stop();
  } else {  
    status = STATUS_ADDRESS_ACK;
    expected = cmd->len;
    saved_cmd = cmd->cmd;

    /* check if transfer is already done (or failed) */
    if((cmd->cmd & CMD_I2C_END) && !expected) 
      i2c_stop();
  }

  /* more data to be expected? */

  LED_PORT &= ~LED_BV;

  return(cmd->len?0xff:0x00);
}





// ----------------------------------------------------------------------
// Handle an IN packet.
// ----------------------------------------------------------------------
uchar usbFunctionRead(uchar *data, uchar len)
{
  uchar i;

  DEBUGF("read %d bytes, %d exp\n", len, expected);

  if(status == STATUS_ADDRESS_ACK) {
    if(len > expected) {
      DEBUGF("exceeds!\n");
      len = expected;
    }

    // consume bytes
    for(i=0;i<len;i++) {
      expected--;
      *data = i2c_get_u08(expected == 0);
      DEBUGF("data = %x\n", *data);
      data++;
    }

    // end transfer on last byte
    if((saved_cmd & CMD_I2C_END) && !expected) 
      i2c_stop();

  } else {
    DEBUGF("not in ack state\n");
    memset(data, 0, len);
  }
  return len;

}

// ----------------------------------------------------------------------
// Handle an OUT packet.
// ----------------------------------------------------------------------
uchar usbFunctionWrite(uchar *data, uchar len)
{
  uchar i, err=0;

  DEBUGF("write %d bytes, %d exp\n", len, expected);

  if(status == STATUS_ADDRESS_ACK) {
    if(len > expected) {
      DEBUGF("exceeds!\n");
      len = expected;
    }

    // consume bytes
    for(i=0;i<len;i++) {
      expected--;
      DEBUGF("data = %x\n", *data);
      if(!i2c_put_u08(*data++))
	err = 1;
    }

    // end transfer on last byte
    if((saved_cmd & CMD_I2C_END) && !expected) 
      i2c_stop();

    if(err) {
      DEBUGF("write failed\n");
      //TODO: set status
    }

  } else {
    DEBUGF("not in ack state\n");
    memset(data, 0, len);
  }

  return len;
}


/* ------------------------------------------------------------------------- */
/* ------------------------ interface to USB driver ------------------------ */
/* ------------------------------------------------------------------------- */
uchar	usbFunctionSetup(uchar data[8])
{
  static uchar replyBuf[4];
  usbMsgPtr = replyBuf;
  DEBUGF("Setup %x %x %x %x\n", data[0], data[1], data[2], data[3]);

  switch(data[1]) {

  case CMD_ECHO: // echo (for transfer reliability testing)
    replyBuf[0] = data[2];
    replyBuf[1] = data[3];
    return 2;
    break;

  case CMD_GET_FUNC:
    memcpy_P(replyBuf, &func, sizeof(func));
    return sizeof(func);
    break;

  case CMD_SET_DELAY:
    /* The original device used a 12MHz clock: */
    /* --- */
    /* The delay function used delays 4 system ticks per cycle. */
    /* This gives 1/3us at 12Mhz per cycle. The delay function is */
    /* called twice per clock edge and thus four times per full cycle. */ 
    /* Thus it is called one time per edge with the full delay */ 
    /* value and one time with the half one. Resulting in */
    /* 2 * n * 1/3 + 2 * 1/2 n * 1/3 = n us. */
    /* --- */
    /* On littleWire-like devices, we run at 16.5MHz, so delay must be scaled up. */
    { 
      uint32_t delay = *(unsigned short*)(data+2);
      delay = (delay*1650UL + 600UL) / 1200UL;
      clock_delay = delay;
      if (clock_delay <= DELAY_OVERHEAD) {
	clock_delay = 1;
      } else {
	clock_delay = clock_delay - DELAY_OVERHEAD;
      }
      clock_delay2 = clock_delay/2;
      if(!clock_delay2) clock_delay2 = 1;
    }

    DEBUGF("request for delay %dus\n", clock_delay); 
    break;

  case CMD_I2C_IO:
  case CMD_I2C_IO + CMD_I2C_BEGIN:
  case CMD_I2C_IO                 + CMD_I2C_END:
  case CMD_I2C_IO + CMD_I2C_BEGIN + CMD_I2C_END:
    // these are only allowed as class transfers

    return i2c_do((struct i2c_cmd*)data);
    break;

  case CMD_GET_STATUS:
    replyBuf[0] = status;
    return 1;
    break;

  default:
    // must not happen ...
    break;
  }

  return 0;  // reply len

}

/* ------------------------------------------------------------------------- */
/* ------------------------ Oscillator Calibration ------------------------- */
/* ------------------------------------------------------------------------- */

/* Calibrate the RC oscillator to 8.25 MHz. The core clock of 16.5 MHz is
 * derived from the 66 MHz peripheral clock by dividing. Our timing reference
 * is the Start Of Frame signal (a single SE0 bit) available immediately after
 * a USB RESET. We first do a binary search for the OSCCAL value and then
 * optimize this value with a neighboorhod search.
 * This algorithm may also be used to calibrate the RC oscillator directly to
 * 12 MHz (no PLL involved, can therefore be used on almost ALL AVRs), but this
 * is wide outside the spec for the OSCCAL value and the required precision for
 * the 12 MHz clock! Use the RC oscillator calibrated to 12 MHz for
 * experimental purposes only!
 */
static void calibrateOscillator(void)
{
uchar       step = 128;
uchar       trialValue = 0, optimumValue;
int         x, optimumDev, targetValue = (unsigned)(1499 * (double)F_CPU / 10.5e6 + 0.5);

    /* do a binary search: */
    do{
        OSCCAL = trialValue + step;
        x = usbMeasureFrameLength();    /* proportional to current real frequency */
        if(x < targetValue)             /* frequency still too low */
            trialValue += step;
        step >>= 1;
    }while(step > 0);
    /* We have a precision of +/- 1 for optimum OSCCAL here */
    /* now do a neighborhood search for optimum value */
    optimumValue = trialValue;
    optimumDev = x; /* this is certainly far away from optimum */
    for(OSCCAL = trialValue - 1; OSCCAL <= trialValue + 1; OSCCAL++){
        x = usbMeasureFrameLength() - targetValue;
        if(x < 0)
            x = -x;
        if(x < optimumDev){
            optimumDev = x;
            optimumValue = OSCCAL;
        }
    }
    OSCCAL = optimumValue; 
}

void usbEventResetReady(void)
{
    calibrateOscillator();
    eeprom_write_byte(0, OSCCAL);   /* store the calibrated value in EEPROM */

    // the timer has run for a while and we can store a new serial number
    // in eeprom
    if(TCCR1 & (1<<CS10))
    {
      uint16_t val = TCNT1;
      eeprom_write_byte((EE_addr+0), '0' + (val/1000) % 10);
      eeprom_write_byte((EE_addr+1), '0' + (val/100) % 10);
      eeprom_write_byte((EE_addr+2), '0' + (val/10) % 10);
      eeprom_write_byte((EE_addr+3), '0' + (val/1) % 10);
      usbDescriptorStringSerialNumber[1] = eeprom_read_byte(EE_addr+0);
      usbDescriptorStringSerialNumber[2] = eeprom_read_byte(EE_addr+1);
      usbDescriptorStringSerialNumber[3] = eeprom_read_byte(EE_addr+2);
      usbDescriptorStringSerialNumber[4] = eeprom_read_byte(EE_addr+3);
    }
}


static inline void initSerialNumber();

/* ------------------------------------------------------------------------- */
/* --------------------------------- main ---------------------------------- */
/* ------------------------------------------------------------------------- */
int main(void) {
	uchar   i;
	uchar   calibrationValue;

    clock_prescale_set(clock_div_1);
	
    calibrationValue = eeprom_read_byte(0); /* calibration value from last time */
    if(calibrationValue != 0xff){
        OSCCAL = calibrationValue;
    }

    initSerialNumber();

    i2c_init();

    // i2c_scan();
    
    usbDeviceDisconnect();
    for(i=0;i<20;i++){  /* 300 ms disconnect */
        _delay_ms(15);
    }
    usbDeviceConnect();

    wdt_enable(WDTO_1S);

    usbInit();
    sei();

	pinMode(B,1,OUTPUT);



	pinMode(B,5,INPUT);
	internalPullup(B,5,DISABLE);
	
    for(;;)
	{
        wdt_reset();
        usbPoll();				
	}

    return 0; 
}

static inline void initSerialNumber()
{
    uint8_t eepromProblem = 0;	

    char val1 = eeprom_read_byte(EE_addr+0);
    char val2 = eeprom_read_byte(EE_addr+1);
    char val3 = eeprom_read_byte(EE_addr+2);
    char val4 = eeprom_read_byte(EE_addr+3);

    // ascii 48 -> '0' , 57 -> '9'

    if((val1 < 48) || (val1 > 57))
    {
    	eepromProblem = 1;
    }
    else if((val2 < 48) || (val2 > 57))
    {
    	eepromProblem = 1;
    }
    else if((val3 < 48) || (val3 > 57))
    {
    	eepromProblem = 1;
    }
    else if((val4 < 48) || (val4 > 57))
    {
    	eepromProblem = 1;
    }
    /* start timer to force creation of a new random serial number ... */
    if(eepromProblem)
    {
      TCCR1 = (1<<CS10);  // run timer at full cpu speed
    }
    
	usbDescriptorStringSerialNumber[1] = eeprom_read_byte(EE_addr+0);
	usbDescriptorStringSerialNumber[2] = eeprom_read_byte(EE_addr+1);
	usbDescriptorStringSerialNumber[3] = eeprom_read_byte(EE_addr+2);
	usbDescriptorStringSerialNumber[4] = eeprom_read_byte(EE_addr+3);
}
