harbaum/I2C-Tiny-USB/(commit log)

2016-01-11 Project import
    [interface.brd, interface.sch]
2017-11-02 Add an empty KiCad project
    [interface.kicad_pcb, interface.sch]
2017-11-02 Add the KiCad schematic
    [interface.sch]
2017-11-02 Create a PCB footprint
    [interface.kicad_pcb]
2017-11-02 Ignore generated KiCad files
2017-11-03 Change to rectangular PCB design
    [interface.kicad_pcb]
2017-11-03 Change the small voltage regulator capacitor footprint
    [interface.kicad_pcb]
2017-11-03 Increase via pad size to 1.6 mm
    [interface.kicad_pcb]
2018-08-14 Fix compilation issues on Ubuntu 18.04
    [usbdrv.h]
2020-04-04 add a new PCB design with 3V3 output, laid out with modern Kicad
    [i2c-tiny-usb.kicad_pcb, i2c-tiny-usb.scad, i2c-tiny-usb.sch, i2c-tiny-usb.stl]
2022-01-10 modify usbconfig.h to support different usb layout for non-attiny45 boards
2022-01-10 Port i2c-tiny-usb project to tinyUSBboard
