harbaum/I2C-Tiny-USB/(notices)

Notices in the files:
firmware/usbtiny/def.h:
This is free software, licensed under the terms of the GNU General
Public License as published by the Free Software Foundation.
kernel/i2c-tiny-usb.c:
modify it under the terms of the GNU General Public License as
published by the Free Software Foundation, version 2.
kernel/chips/cmps03.c:
This program is free software; you can redistribute it and/or modify
it under the terms of the GNU General Public License as published by
the Free Software Foundation; either version 2 of the License, or
(at your option) any later version.
digispark/main.c:
modify it under the terms of the GNU General Public License
